WallieEverest/tt03/src/tb_morningjava_top.sv

// Title:   Square root testbench
// File:    tb_morningjava_top.sv
// Author:  Wallace Everest
// Date:    23-NOV-2022
// URL:     https://github.com/wallieeverest/tt03
// License: Apache 2.0

`default_nettype none
`timescale 1us/100ns

module a_tb_morning_java_top ();
  localparam WIDTH = 10;  // number of bits in message
  localparam DELAY = WIDTH+1; // assume two stop bits
  localparam [WIDTH-1:0] IDLE = ~0;
  localparam START = 1'b0;
  localparam STOP  = 1'b1;

  reg  [WIDTH-1:0] message = IDLE;  // default to IDLE pattern
  reg  clk = 0;
  wire uart_clk = clk;  // uart clock is same as system clock for this version
  reg  mode = 1;  // choose external serial mode
  wire [7:0] io_in;
  wire [7:0] io_out;
  wire [3:0] dac  = io_out[4:0];
  wire       rtck = io_out[5];
  wire       tdo  = io_out[7];
  wire tck = rtck;
  reg  tms = 0;
  wire tdi = message[0];
  assign io_in[0] = clk;
  assign io_in[1] = 0;
  assign io_in[2] = 0;
  assign io_in[3] = mode;
  assign io_in[4] = uart_clk;
  assign io_in[5] = tck;
  assign io_in[6] = tms;
  assign io_in[7] = tdi;
 
  morningjava_top dut (
    .io_in (io_in),
    .io_out(io_out)
  );

  initial forever #104 clk = ~clk;  // 4800 Hz system clock
  
  initial begin
    repeat (2) @(negedge tck);
    tms = 0;  // select address
    message = {STOP,8'h01,START};  // select project 1
    repeat (DELAY) @(negedge tck) message = {STOP, message[WIDTH-1:1]};
    tms = 1;  // select data
    message = {STOP,8'h01,START};
    repeat (DELAY) @(negedge tck) message = {STOP, message[WIDTH-1:1]};
    message = {STOP,8'h10,START};  // select tap 2
    repeat (DELAY) @(negedge tck) message = {STOP, message[WIDTH-1:1]};
    message = {STOP,8'h22,START};  // send data
    repeat (DELAY) @(negedge tck) message = {STOP, message[WIDTH-1:1]};
    message = {STOP,8'h30,START};  // send data
    repeat (DELAY) @(negedge tck) message = {STOP, message[WIDTH-1:1]};
    message = {STOP,8'h43,START};  // deselect tap 2
    repeat (DELAY) @(negedge tck) message = {STOP, message[WIDTH-1:1]};
    message = {STOP,8'h50,START};  // send data
    repeat (DELAY) @(negedge tck) message = {STOP, message[WIDTH-1:1]};
    message = {STOP,8'h64,START};  // deselect tap 2
    repeat (DELAY) @(negedge tck) message = {STOP, message[WIDTH-1:1]};
    message = {STOP,8'h70,START};  // send data
    repeat (DELAY) @(negedge tck) message = {STOP, message[WIDTH-1:1]};
    repeat (2) @(negedge tck);

  end
endmodule
