WallieEverest/tt03/src/pulse.v

// File: pulse.v

`default_nettype none

module pulse (
  input wire              apu_clk,
  input wire              qtr_clk,
  input wire              hlf_clk,
  input wire        [7:0] reg_0,
  input wire        [7:0] reg_1,
  input wire        [7:0] reg_2,
  input wire        [7:0] reg_3,
  input wire              reg_change,
  output reg signed [4:0] pulse_out = 0
);

  // Input registers
  wire [1:0]  duty_cycle_field = reg_0[7:6];
  wire        counter_enable   = reg_0[5];
  wire        envelope_decay   = reg_0[4];
  wire [3:0]  envelope_period  = reg_0[3:0];
  wire        sweep_enable     = reg_1[7];
  wire [2:0]  sweep_period     = reg_1[6:4];
  wire        sweep_decrement  = reg_1[3];
  wire [2:0]  sweep_shift      = reg_1[2:0];
  wire [10:0] wavelength       = {reg_3[2:0], reg_2};
  wire [ 4:0] length_select    = reg_3[7:3];
  
  // Duty cycle logic
  reg [7:0] duty_cycle = 0;
  
  always @( duty_cycle_field )
  begin
    case ( duty_cycle_field )
      0: duty_cycle <= 8'b00000010;
      1: duty_cycle <= 8'b00000110;
      2: duty_cycle <= 8'b00011110;
      3: duty_cycle <= 8'b11111001;
    endcase
  end
  
  // Length counter logic
  reg [ 7:0] length_preload;

  always @( length_select )
  begin
    case ( length_select )
       0: length_preload <= 8'h0A;
       1: length_preload <= 8'hFE;
       2: length_preload <= 8'h14;
       3: length_preload <= 8'h02;
       4: length_preload <= 8'h28;
       5: length_preload <= 8'h04;
       6: length_preload <= 8'h50;
       7: length_preload <= 8'h06;
       8: length_preload <= 8'hA0;
       9: length_preload <= 8'h08;
      10: length_preload <= 8'h3C;
      11: length_preload <= 8'h0A;
      12: length_preload <= 8'h0E;
      13: length_preload <= 8'h0C;
      14: length_preload <= 8'h1A;
      15: length_preload <= 8'h0E;
      16: length_preload <= 8'h0C;
      17: length_preload <= 8'h10;
      18: length_preload <= 8'h18;
      19: length_preload <= 8'h12;
      20: length_preload <= 8'h30;
      21: length_preload <= 8'h14;
      22: length_preload <= 8'h60;
      23: length_preload <= 8'h16;
      24: length_preload <= 8'hC0;
      25: length_preload <= 8'h18;
      26: length_preload <= 8'h48;
      27: length_preload <= 8'h1A;
      28: length_preload <= 8'h10;
      29: length_preload <= 8'h1C;
      30: length_preload <= 8'h20;
      31: length_preload <= 8'h1E;
    endcase
  end
  
  // Sweep unit
  reg [ 7:0] length_counter = 0;
  reg        swp_reload = 0;
  reg [ 2:0] swp_div = 0;
  reg [10:0] timer_preload = 0;
  reg        swp_change = 0;

  always @( posedge hlf_clk ) begin
    if ( swp_reload ) begin
      length_counter <= length_preload;
      swp_div        <= sweep_period;
      timer_preload  <= wavelength;
      swp_change       <= reg_change;

      // Adjust pulse channel period
      // Eventually need to check if target period > 0x7ff
      // and other checks as well
      if ( (swp_div == 0) && sweep_enable ) 
        // Sweep down to lower frequencies
        if ( !sweep_decrement ) 
          timer_preload <= timer_preload + (wavelength >> sweep_shift);
        else  // Sweep up to higher frequencies
          timer_preload <= timer_preload - (wavelength >> sweep_shift);
    end else begin
      if ( !counter_enable && (length_counter != 0) )
        length_counter <= length_counter - 1;

      if ( swp_div != 0 ) 
        swp_div <= swp_div - 1;
      else if ( sweep_enable ) begin
        swp_div <= sweep_period;

        // Adjust pulse channel period
        // Eventually need to implement other checks as well
        if ( !sweep_decrement ) // Sweep down to lower frequencies
          timer_preload <= timer_preload + (wavelength >> sweep_shift);
        else  // Sweep up to higher frequencies
          timer_preload <= timer_preload - (wavelength >> sweep_shift);
      end

      if ( swp_reload )
        swp_reload <= 0;
      else if ( swp_change != reg_change ) 
        swp_reload <= 1;
    end
  end

 // Envelope unit
  reg        envelope_start = 0;
  reg [ 3:0] envelope_prescale = 0;
  reg [ 3:0] envelope_counter = 0;
  reg [ 3:0] envelope_out = 0;
  reg        env_change = 0;

  always @( posedge qtr_clk ) begin
    if ( envelope_start ) begin
      envelope_prescale <= envelope_period;
      envelope_counter <= ~0;
      env_change <= reg_change;
    end else begin
      if ( envelope_prescale == 0 ) begin
        envelope_prescale <= envelope_period;

        if ( envelope_counter != 0 ) 
          envelope_counter <= envelope_counter - 1;
        else if ( counter_enable ) 
          envelope_counter <= ~0;
      end else 
        envelope_prescale <= envelope_prescale - 1;
      
      if ( envelope_decay ) 
        envelope_out <= envelope_period;
      else 
        envelope_out <= envelope_counter;
    end 

    if ( envelope_start )
      envelope_start <= 0;
    else if ( env_change != reg_change ) 
      envelope_start <= 1;
  end

  // Timer & sequencer
  reg        seq_reset = 0;
  reg [10:0] timer_counter = 0;
  reg [ 2:0] duty_cycle_index = 0;
  reg        seq_change = 0;

  always @( posedge apu_clk ) begin
    if ( seq_reset ) begin
      duty_cycle_index <= 0;
      timer_counter    <= timer_preload;
      seq_change         <= reg_change;
    end else if ( length_counter != 0 )
      if (timer_counter == 0) begin
        timer_counter <= timer_preload;
        duty_cycle_index <= duty_cycle_index - 1;
        if ( ( duty_cycle >> duty_cycle_index ) & 8'h1 ) 
          pulse_out <=  envelope_out;
        else 
          pulse_out <= -envelope_out;            
      end else
        timer_counter <= timer_counter - 1;

    if ( seq_reset )
      seq_reset <= 0;
    else if ( seq_change != reg_change )
      seq_reset <= 1;
  end
  
endmodule
