WallieEverest/tt03/(commit log)

2023-03-26 Fixed pin count in yaml
2023-03-29 Add pin tabel
2023-04-14 remove image boarders
2023-04-19 add pin table
2023-04-20 shortened envelope by 24 FF
    [decoder.v, frame_counter.v, pulse.v]
2023-04-20 simplified timer
